AssociationRobotTelecomStrasbourg/CarteM-re1A2A-CFR2020/CarteMere.kicad_pcb

## KiCad design CarteMere.kicad_pcb (2020-06-20)

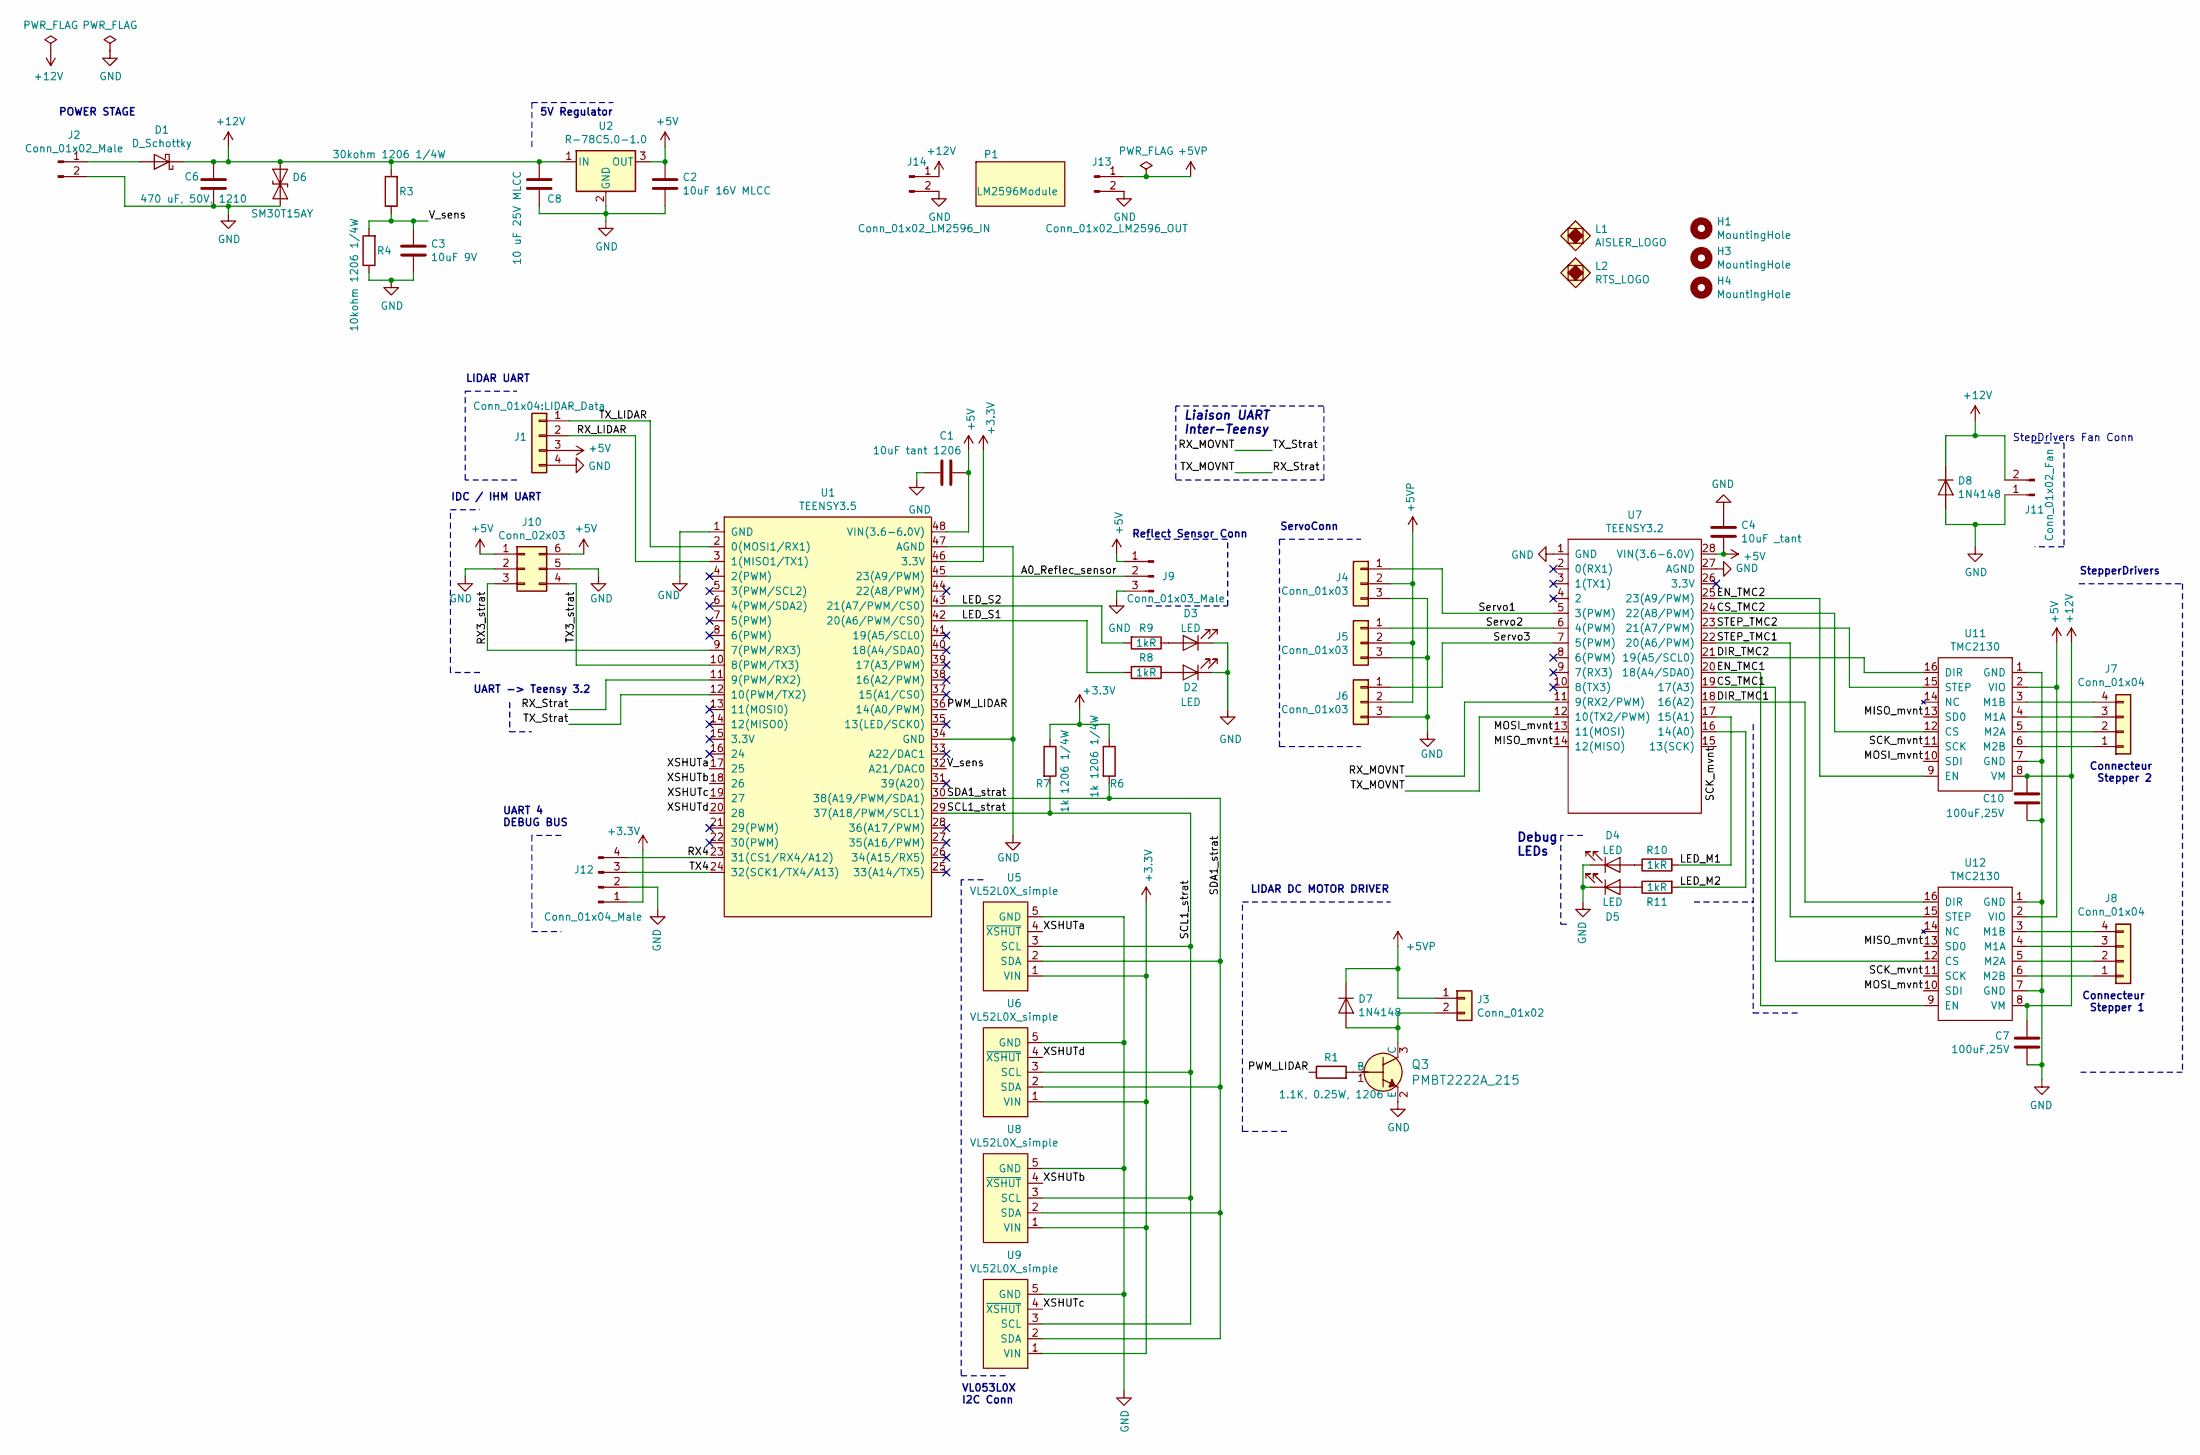
[picture p1: schematic CarteMere.sch, Carte-mère Robot]

Parts:
C1: 10uF tant 1206; C_1206_3216Metric_Pad1.42x1.75mm_HandSolder
C2: 10uF 16V MLCC; C_1206_3216Metric_Pad1.42x1.75mm_HandSolder
C3: 10uF 9V; C_1206_3216Metric_Pad1.42x1.75mm_HandSolder
C4: 10uF _tant; C_1206_3216Metric_Pad1.42x1.75mm_HandSolder
C6: 470 uF, 50V, 1210; C_1210_3225Metric_Pad1.42x2.65mm_HandSolder
C7, C10: 100uF,25V; CP_Radial_D6.3mm_P2.50mm
C8: 10 uF 25V MLCC; C_1206_3216Metric_Pad1.42x1.75mm_HandSolder
D1: D_Schottky; D_SMA_Handsoldering
D2, D3, D4, D5: LED; LED_1206_3216Metric_Pad1.42x1.75mm_HandSolder
D6: SM30T15AY; D_SMC_Handsoldering
D7, D8: 1N4148; D_SOD-123
H1, H3, H4: MountingHole; MountingHole_3.2mm_M3
J1: Conn_01x04:LIDAR_Data; JST_PH_B4B-PH-K_1x04_P2.00mm_Vertical
J2: Conn_01x02_Male; OSTOQ027151
J3: Conn_01x02; JST_PH_B2B-PH-K_1x02_P2.00mm_Vertical
J4, J5, J6: Conn_01x03; PinHeader_1x03_P2.54mm_Vertical
J7, J8: Conn_01x04; JST_XH_B4B-XH-A_1x04_P2.50mm_Vertical
J9: Conn_01x03_Male; PinSocket_1x03_P2.54mm_Vertical
J10: Conn_02x03; IDC-Header_2x03_P2.54mm_Vertical
J11: Conn_01x02_Fan; JST_XH_B2B-XH-A_1x02_P2.50mm_Vertical
J12: Conn_01x04_Male; JST_XH_B4B-XH-AM_1x04_P2.50mm_Vertical
J13: Conn_01x02_LM2596_OUT; BatConn
J14: Conn_01x02_LM2596_IN; BatConn
L1: AISLER_LOGO; aisler
L2: RTS_LOGO; rts
P1: LM2596Module; LM2596 Module
Q3: PMBT2222A_215; SOT-23_DGS_Handsoldering; MPN PMBT2222A,215; Digi-Key_PN 1727-2956-1-ND
R1: 1.1K, 0.25W, 1206; R_1206_3216Metric_Pad1.42x1.75mm_HandSolder
R3: 30kohm 1206 1/4W; R_1206_3216Metric_Pad1.42x1.75mm_HandSolder
R4: 10kohm 1206 1/4W; R_1206_3216Metric_Pad1.42x1.75mm_HandSolder
R6, R7: 1k 1206 1/4W; R_1206_3216Metric_Pad1.42x1.75mm_HandSolder
R8, R9, R10, R11: 1kR; R_1206_3216Metric_Pad1.42x1.75mm_HandSolder
U1: TEENSY3.5; Teensy3.6_RTS
U2: R-78C5.0-1.0; Converter_DCDC_RECOM_R-78E-0.5_THT
U5, U6, U8, U9: VL52L0X_simple; JST_XH_B5B-XH-A_1x05_P2.50mm_Vertical
U7: TEENSY3.2; TEENSY3.2_RTS
U11, U12: TMC2130; TMC2130_breakout

Connections:
+3V3: J12.1, R6.1, R7.1, U1.46 (3.3V), U5.1 (VIN), U6.1 (VIN), U8.1 (VIN), U9.1 (VIN)
+5V: C1.1, C2.1, C4.2, J1.3, J9.1, J10.1, J10.6, U1.48 (VIN(3.6-6.0V)), U2.3 (OUT), U7.28 (VIN(3.6-6.0V)), U11.2 (VIO), U12.2 (VIO)
+5VP: D7.1 (K), J3.1, J4.2, J5.2, J6.2, J13.1
+12V: C6.1, C7.1, C8.1, C10.1, D1.1 (K), D6.1 (A1), D8.1 (K), J11.2, J14.1, R3.2, U2.1 (IN), U11.8 (VM), U12.8 (VM)
/A0_Reflec_sensor: J9.2, U1.45 (23(A9/PWM))
/CS_TMC1: U7.19 (17(A3)), U12.12 (CS)
/CS_TMC2: U7.24 (22(A8/PWM)), U11.12 (CS)
/DIR_TMC1: U7.18 (16(A2)), U12.16 (DIR)
/DIR_TMC2: U7.21 (19(A5/SCL0)), U11.16 (DIR)
/EN_TMC1: U7.20 (18(A4/SDA0)), U12.9 (EN)
/EN_TMC2: U7.25 (23(A9/PWM)), U11.9 (EN)
/LED_M1: R10.2, U7.17 (15(A1))
/LED_M2: R11.2, U7.16 (14(A0))
/LED_S1: R8.2, U1.42 (20(A6/PWM/CS0))
/LED_S2: R9.2, U1.43 (21(A7/PWM/CS0))
/MISO_mvnt: U7.14 (12(MISO)), U11.13 (SD0), U12.13 (SD0)
/MOSI_mvnt: U7.13 (11(MOSI)), U11.10 (SDI), U12.10 (SDI)
/PWM_LIDAR: R1.1, U1.36 (14(A0/PWM))
/RX3_strat: J10.3, U1.9 (7(PWM/RX3))
/RX4: J12.4, U1.23 (31(CS1/RX4/A12))
/RX_LIDAR: J1.2, U1.3 (1(MISO1/TX1))
/RX_MOVNT: U1.12 (10(PWM/TX2)), U7.11 (9(RX2/PWM))
/RX_Strat: U1.11 (9(PWM/RX2)), U7.12 (10(TX2/PWM))
/SCK_mvnt: U7.15 (13(SCK)), U11.11 (SCK), U12.11 (SCK)
/SCL1_strat: R7.2, U1.29 (37(A18/PWM/SCL1)), U5.3 (SCL), U6.3 (SCL), U8.3 (SCL), U9.3 (SCL)
/SDA1_strat: R6.2, U1.30 (38(A19/PWM/SDA1)), U5.2 (SDA), U6.2 (SDA), U8.2 (SDA), U9.2 (SDA)
/STEP_TMC1: U7.22 (20(A6/PWM)), U12.15 (STEP)
/STEP_TMC2: U7.23 (21(A7/PWM)), U11.15 (STEP)
/Servo1: J4.1, U7.5 (3(PWM))
/Servo2: J5.1, U7.6 (4(PWM))
/Servo3: J6.1, U7.7 (5(PWM))
/TX3_strat: J10.4, U1.10 (8(PWM/TX3))
/TX4: J12.3, U1.24 (32(SCK1/TX4/A13))
/TX_LIDAR: J1.1, U1.2 (0(MOSI1/RX1))
/V_sens: C3.1, R3.1, R4.2, U1.32 (A21/DAC0)
/XSHUTa: U1.17 (25), U5.4 (~XSHUT)
/XSHUTb: U1.18 (26), U8.4 (~XSHUT)
/XSHUTc: U1.19 (27), U9.4 (~XSHUT)
/XSHUTd: U1.20 (28), U6.4 (~XSHUT)
GND: C1.2, C2.2, C3.2, C4.1, C6.2, C7.2, C8.2, C10.2, D2.1 (K), D3.1 (K), D4.1 (K), D5.1 (K), D6.2 (A2), D8.2 (A), J1.4, J2.2, J4.3, J5.3, J6.3, J9.3, J10.2, J10.5, J11.1, J12.2, J13.2, J14.2, Q3.2 (E), R4.1, U1.1 (GND), U1.34 (GND), U1.47 (AGND), U2.2 (GND), U5.5 (GND), U6.5 (GND), U7.1 (GND), U7.27 (AGND), U8.5 (GND), U9.5 (GND), U11.1 (GND), U11.7 (GND), U12.1 (GND), U12.7 (GND)
unnamed: D1.2 (A), J2.1
unnamed: D2.2 (A), R8.1
unnamed: D3.2 (A), R9.1
unnamed: D4.2 (A), R10.1
unnamed: D5.2 (A), R11.1
unnamed: D7.2 (A), J3.2, Q3.3 (C)
unnamed: J7.1, U11.6 (M2B)
unnamed: J7.2, U11.5 (M2A)
unnamed: J7.3, U11.4 (M1A)
unnamed: J7.4, U11.3 (M1B)
unnamed: J8.1, U12.6 (M2B)
unnamed: J8.2, U12.5 (M2A)
unnamed: J8.3, U12.4 (M1A)
unnamed: J8.4, U12.3 (M1B)
unnamed: Q3.1 (B), R1.2

Notes on the sheet:
Connecteur Stepper 1
Liaison UART Inter-Teensy
Connecteur Stepper 2
StepDrivers Fan Conn
IDC / IHM UART
ServoConn
StepperDrivers
VL053L0X I2C Conn
Debug LEDs
LIDAR DC MOTOR DRIVER
UART 4 DEBUG BUS
UART -> Teensy 3.2
LIDAR UART
Reflect Sensor Conn
POWER STAGE
5V Regulator

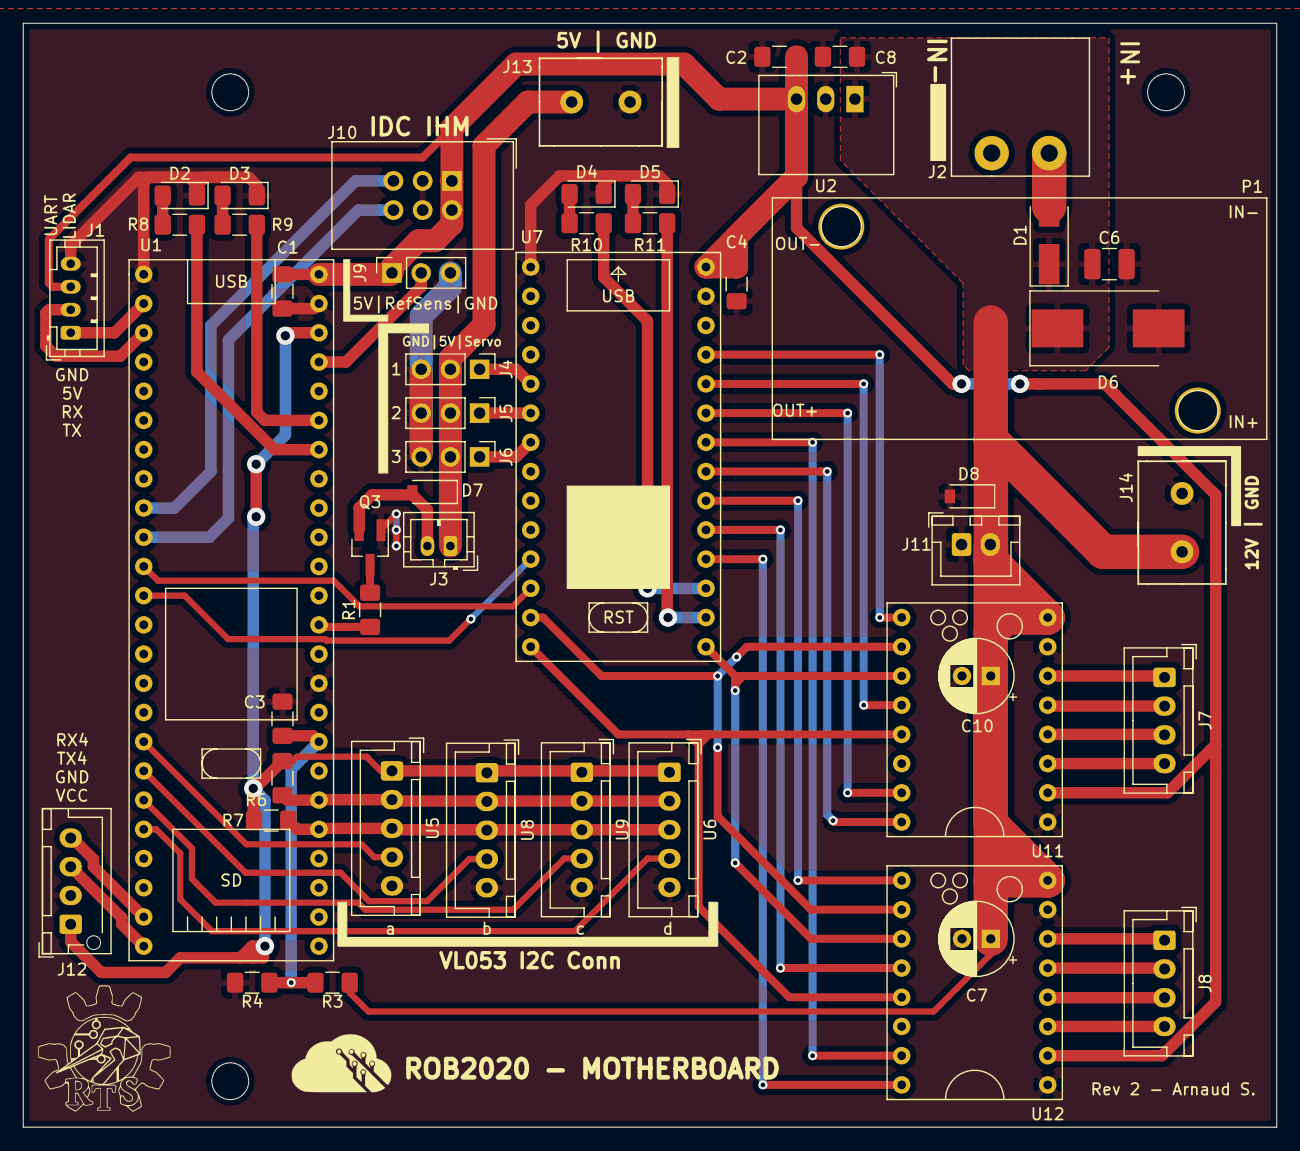
[picture p2: board CarteMere.kicad_pcb from above]

Board: 2 copper layers, 109.0 x 96.0 mm, 55 parts (0 on the bottom side), 55 nets.
