AssociationRobotTelecomStrasbourg/CarteM-re1A2A-CFR2020/(commit log)

2020-02-27 Mise à jour
    [CarteMere.kicad_pcb, CarteMere.sch]
2020-06-20 Nettoyage du schéma, ajout de l'UART 4 sur Teensy 3.6 pour debug, renforcement alimentation 5V
    [CarteMere.kicad_pcb, CarteMere.sch, CarteMere_old.sch, CarteMere_proto.kicad_pcb, CarteMere_v2.0.kicad_pcb]
